radiolok/rln_electro/img/Main.jpg

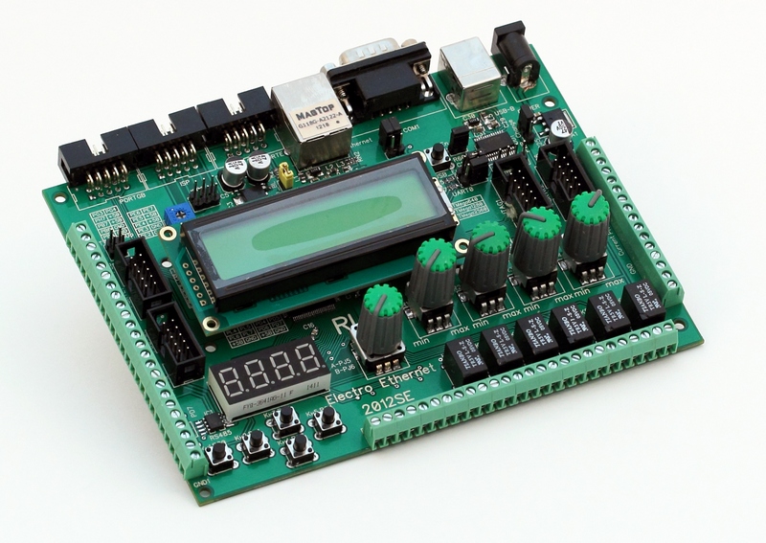
img/Main.jpg
