radiolok/rln_electro/img/2012FE_LegendTop.jpg

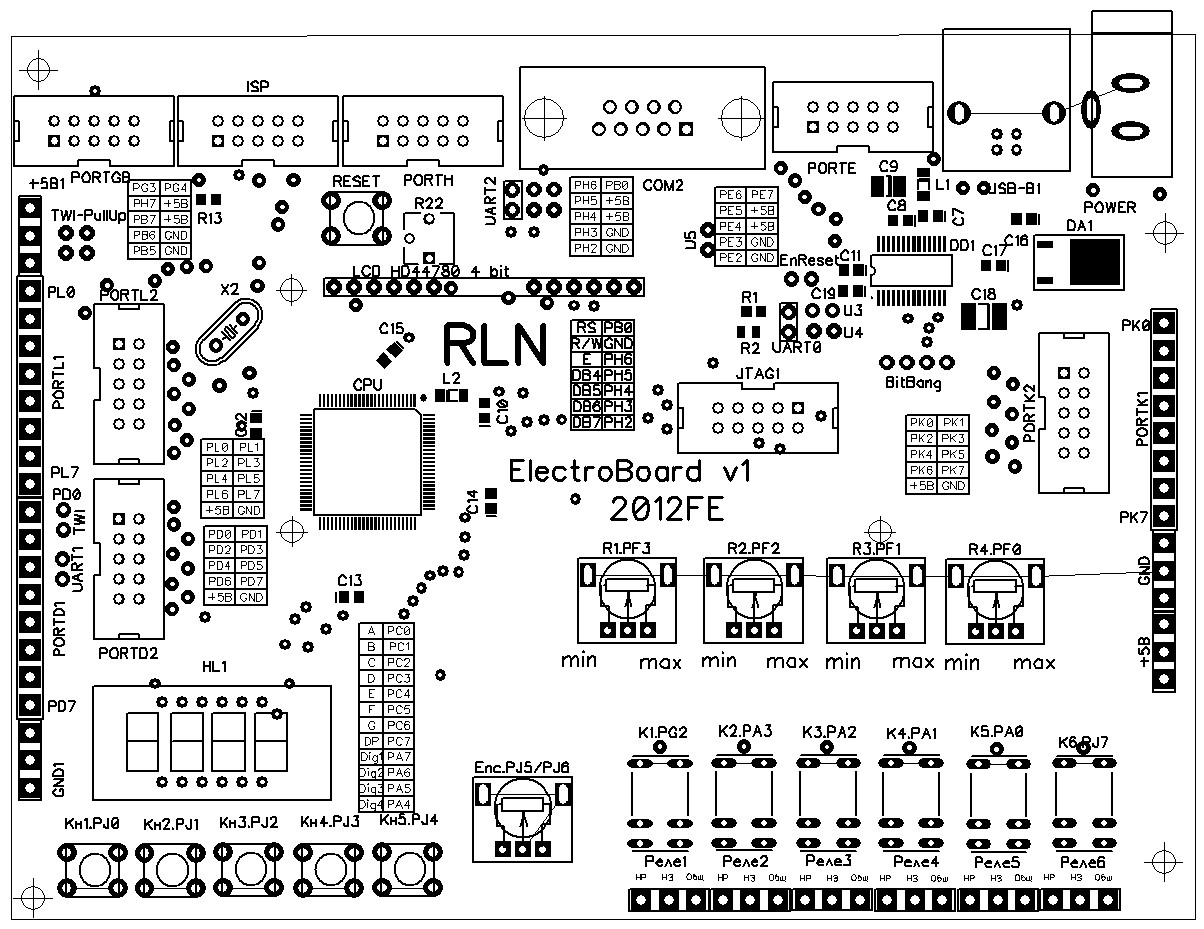
img/2012FE_LegendTop.jpg
