radiolok/rln_electro/img/2012SE_LegendBottom.jpg

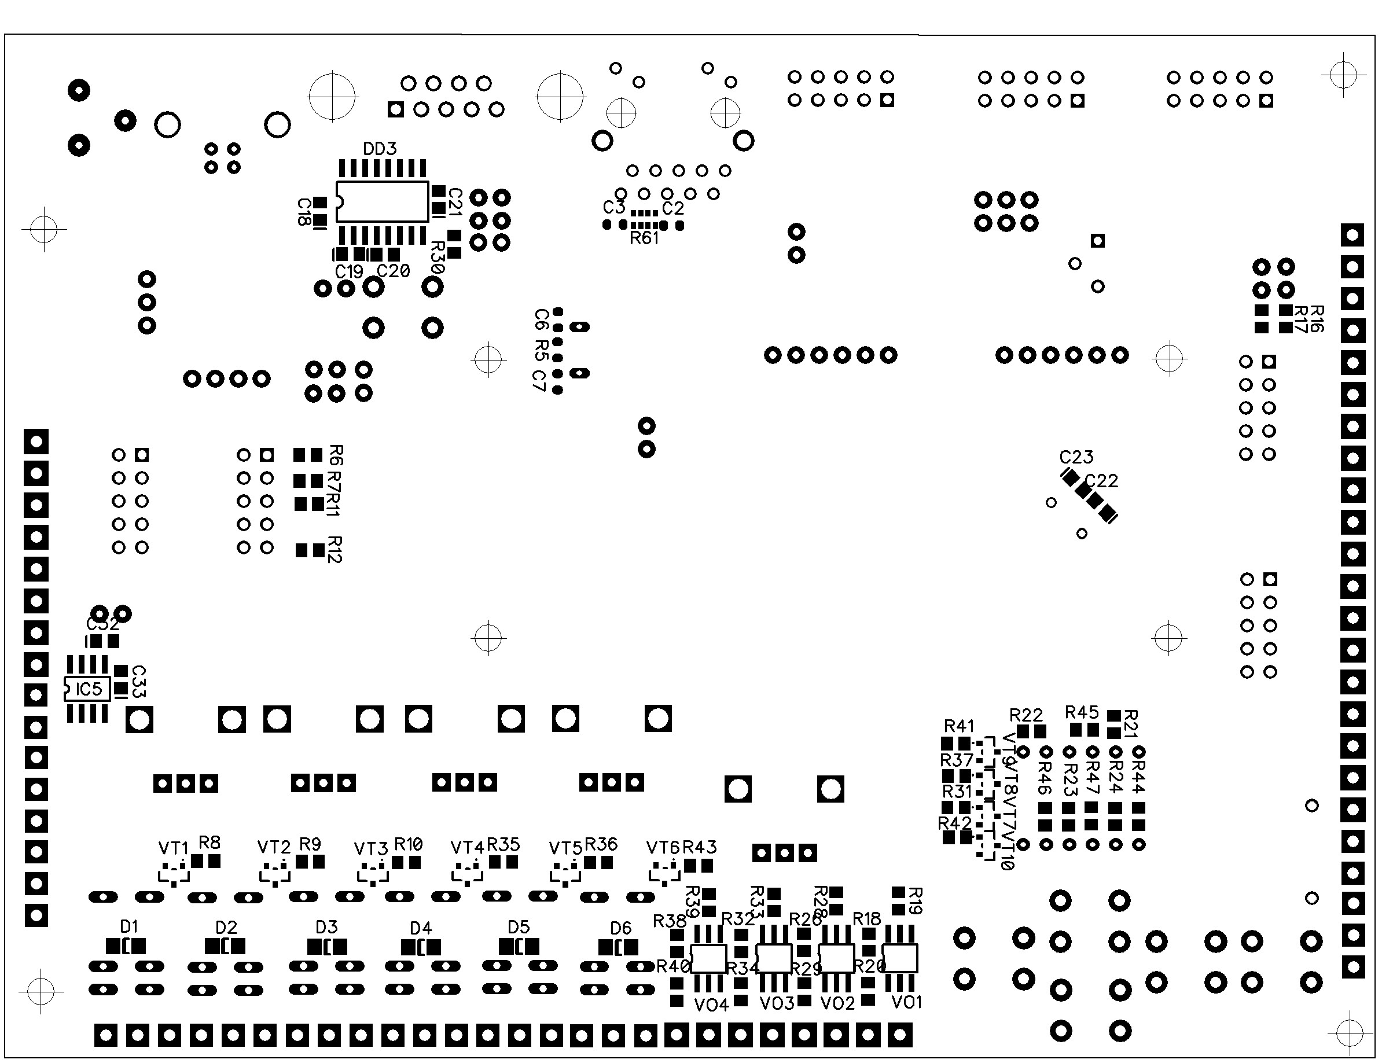
img/2012SE_LegendBottom.jpg
