radiolok/rln_electro/img/2012SE_LegendTop.jpg

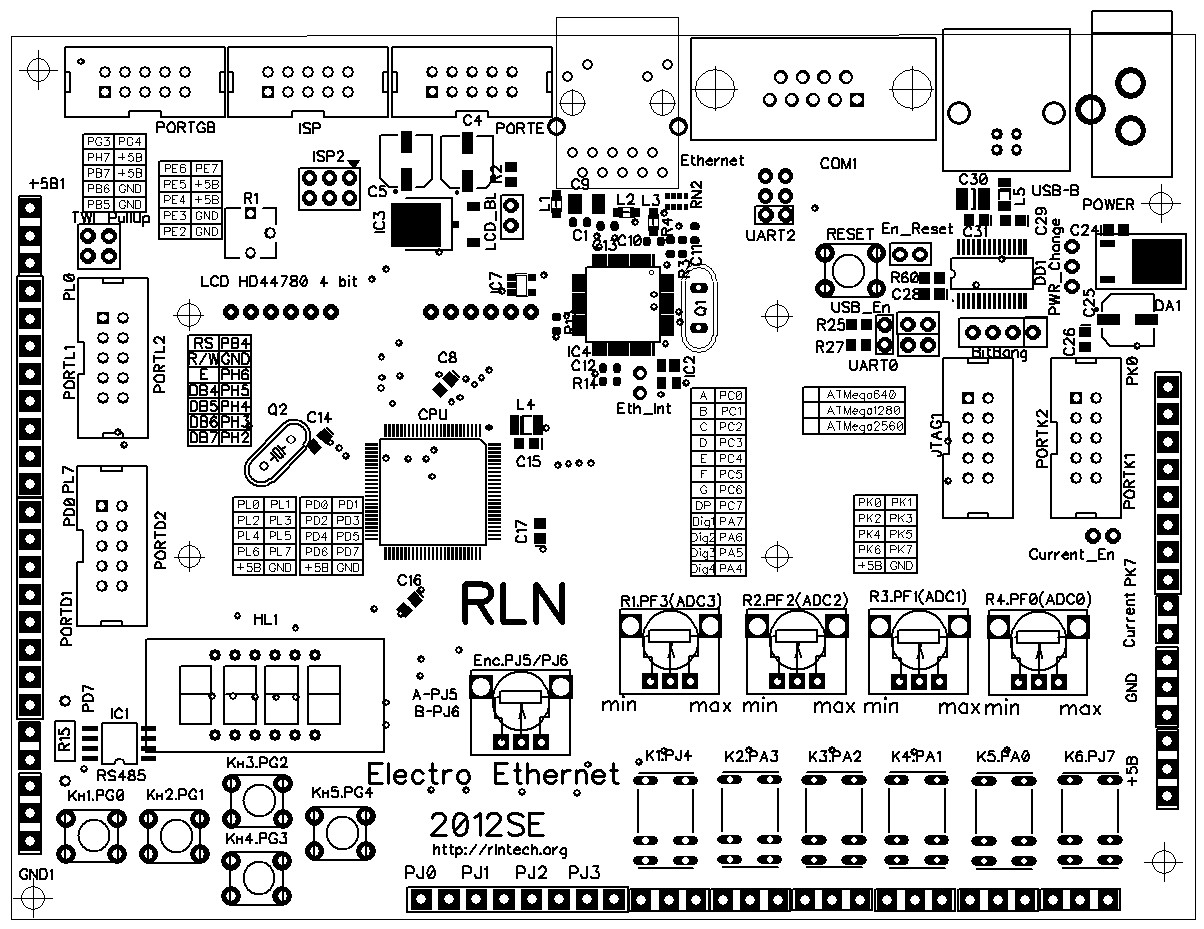
img/2012SE_LegendTop.jpg
