radiolok/rln_electro/doc/2012SE_Schematic.pdf

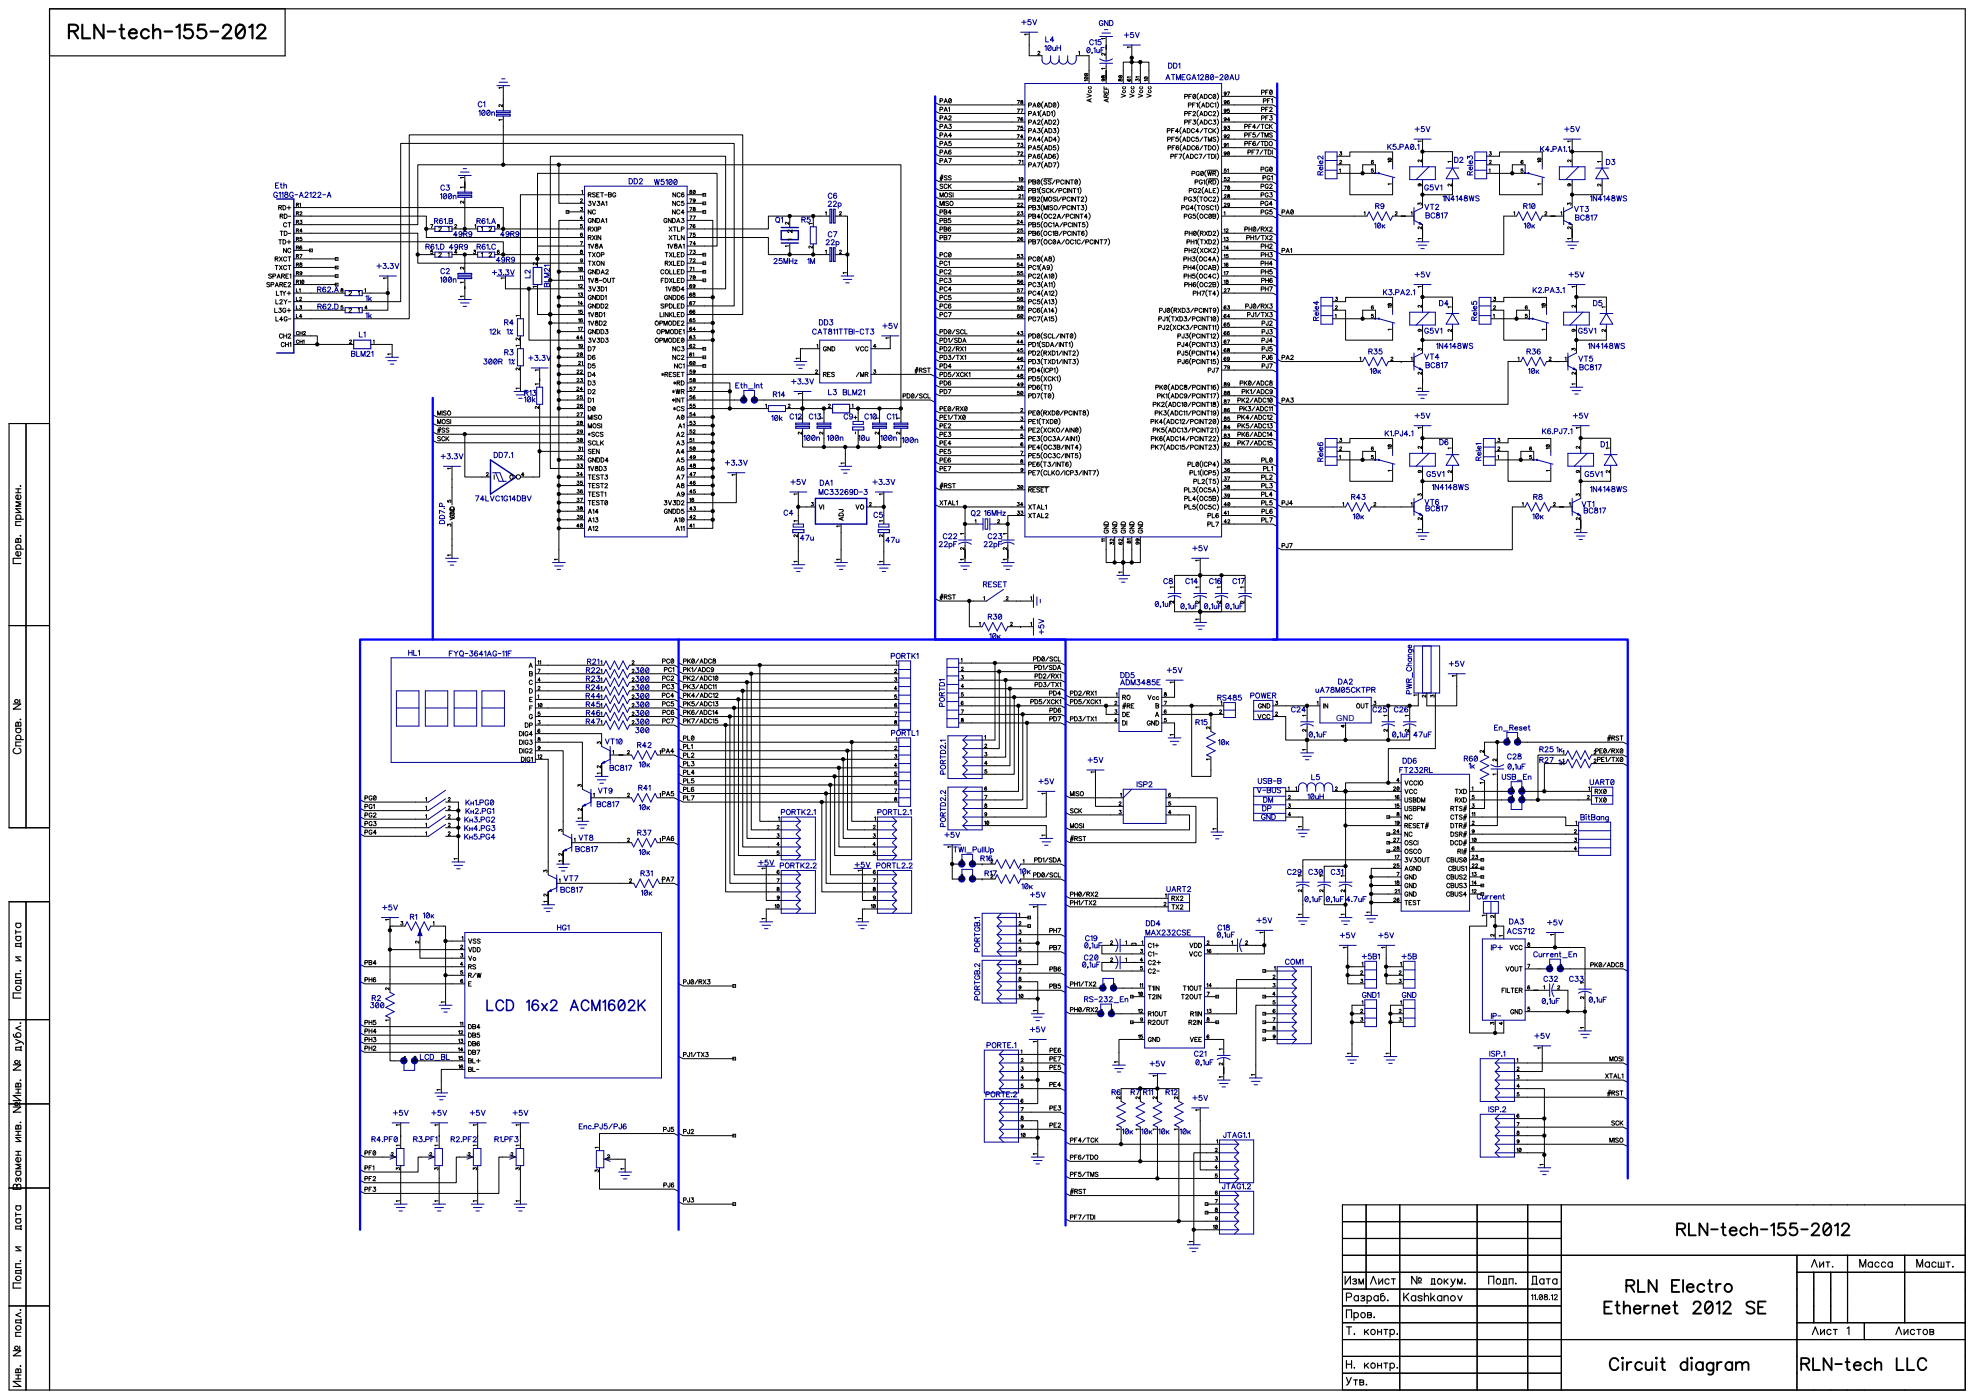
[picture p20: page 1]
GND
