radiolok/rln_electro/(list of files, drawings)

Other design files:
hw/2012_FE/PcbRoute.dip
hw/2012_FE/Schematic.dch
hw/2012_SE/PcbRoute.dip
hw/2012_SE/Schematic.dch
